geranimoekia/Digital-Voting-System/(list of files, drawings)

Other design files:
st21001137_mk21000459_DIGITAL VOTING_SYSTEM.pdsprj
