geranimoekia/Digital-Voting-System/(commit log)

2026-05-21 Initial commit: Digital Voting System (CTEN 415) PIC16F877A-based digital voting system with PIN authentication, 4x4 keypad input, 20x4 LCD display, and LED status indicators. Includes C source, LCD 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
    [st21001137_mk21000459_DIGITAL VOTING_SYSTEM.pdsprj]
2026-05-21 Reformat report.tex to match PALMS main.tex style Switch to report class with newtxtext font, same PALMS geometry, chapter-based structure, siunitx units, booktabs tables, and center-block title page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
